gyfastas/EE397/MCU (Raspberry)/README.md

# Self-Balance-Robot

This project is an assignment in the Intelligent System course (EE397) aiming to implement a self balance robot based on ESP32-DevkitC-V3 and Raspberry Pi 3.

This sub repository contains the source codes of Raspberry in our project.

## Requirements

### Hardware chips

- __MCU(for visual)__ : Raspberry Pi 3
- __Camera__ : PiCamera
- __Edge Computing Support__ : Intel Movidius Neural Compute Stick

### Software

- __Python Version__ : Python 3.6
- __Dependent Libraries__ :
    + opencv-python
    + [ncsdk](https://github.com/movidius/ncsdk)
    + [ncappzoo](https://github.com/movidius/ncappzoo)
