gyfastas/EE397/Host/README.md

# EE397
Our EE397 project

Control UI on Computer

---------

## Environment

Python3.6

Pyqt5

## 上位机指令与通信协议

#### 11.11

前进 后退 左转 右转(WSAD) : 最低指令间隔10ms, 持续时间10ms

移动速度调整: 范围 (0,100) 怎么映射到底层参数上？
