gyfastas/EE397/MCU (Raspberry)/Demo/match.png

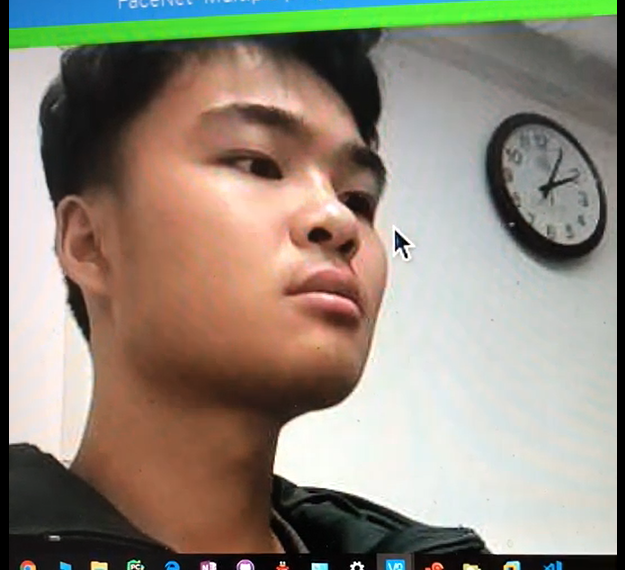
MCU (Raspberry)/Demo/match.png
