gyfastas/EE397/3DPrint/Drawing2.stl

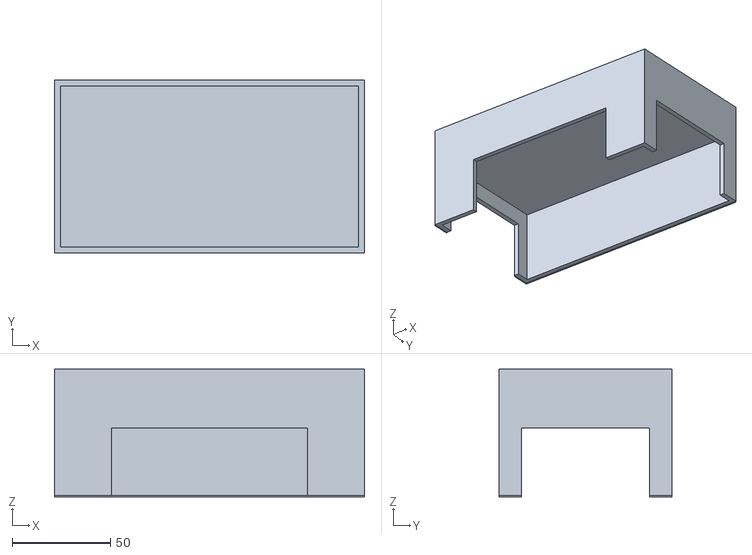
[picture p9: CAD file, 2018-12-17]
3DPrint/Drawing2.stl
158.0 x 88.0 x 65.0
