gyfastas/EE397/(list of files, drawings)

Other design files:
PCB Design/bala.PcbDoc
PCB Design/bala.SchDoc
