gyfastas/EE397/MCU (Raspberry)/live-object-detector_trackbottle.py

#!/usr/bin/python3

# ****************************************************************************
# Copyright(c) 2017 Intel Corporation. 
# License: MIT See LICENSE file in root directory.
# ****************************************************************************

# Detect objects on a LIVE camera feed using
# Intel® Movidius™ Neural Compute Stick (NCS)

import os
import cv2
import sys
import numpy
import ntpath
import argparse
import picamera
import picamera.array
import mvnc.mvncapi as mvnc

from utils import visualize_output
from utils import deserialize_output

import serial
import time
import multiprocess as mp
#import queue


# Detection threshold: Minimum confidance to tag as valid detection
CONFIDANCE_THRESHOLD = 0.60 # 60% confidant

# Variable to store commandline arguments
ARGS                 = None

# OpenCV object for video capture
camera               = None



ser = serial.Serial("/dev/ttyAMA0", 115200)
#open serial
def send(x):
    #字符发送
    ser.write(bytes([0x80]))
    ser.write(bytes([x]))
    ser.write(bytes([0x81]))
    ser.write(bytes([0x81]))

# ---- Step 1: Open the enumerated device and get a handle to it -------------

def open_ncs_device():

    # Look for enumerated NCS device(s); quit program if none found.
    devices = mvnc.EnumerateDevices()
    if len( devices ) == 0:
        print( "No devices found" )
        quit()

    # Get a handle to the first enumerated device and open it
    device = mvnc.Device( devices[0] )
    device.OpenDevice()

    return device

# ---- Step 2: Load a graph file onto the NCS device -------------------------

def load_graph( device ):

    # Read the graph file into a buffer
    with open( ARGS.graph, mode='rb' ) as f:
        blob = f.read()

    # Load the graph buffer into the NCS
    graph = device.AllocateGraph( blob )

    return graph

# ---- Step 3: Pre-process the images ----------------------------------------

def pre_process_image( frame ):

    # Resize image [Image size is defined by choosen network, during training]
    img = cv2.resize( frame, tuple( ARGS.dim ) )

    # Convert RGB to BGR [OpenCV reads image in BGR, some networks may need RGB]
    if( ARGS.colormode == "rgb" ):
        img = img[:, :, ::-1]

    # Mean subtraction & scaling [A common technique used to center the data]
    img = img.astype( numpy.float16 )
    img = ( img - numpy.float16( ARGS.mean ) ) * ARGS.scale

    return img

# ---- Step 4: Read & print inference results from the NCS -------------------

def infer_image( graph, img, frame ):

    # Load the image as a half-precision floating point array
    graph.LoadTensor( img, 'user object' )

    # Get the results from NCS
    output, userobj = graph.GetResult()

    # Get execution time
    inference_time = graph.GetGraphOption( mvnc.GraphOption.TIME_TAKEN )

    # Deserialize the output into a python dictionary
    output_dict = deserialize_output.ssd( 
                      output, 
                      CONFIDANCE_THRESHOLD, 
                      frame.shape )

    # Print the results (each image/frame may have multiple objects)
    print( "I found these objects in "
            + " ( %.2f ms ):" % ( numpy.sum( inference_time ) ) )
    flag = 0

    for i in range( 0, output_dict['num_detections'] ):
        print( "%3.1f%%\t" % output_dict['detection_scores_' + str(i)] 
               + labels[ int(output_dict['detection_classes_' + str(i)]) ]
               + ": Top Left: " + str( output_dict['detection_boxes_' + str(i)][0] )
               + " Bottom Right: " + str( output_dict['detection_boxes_' + str(i)][1] ) )

        # Draw bounding boxes around valid detections 
        (y1, x1) = output_dict.get('detection_boxes_' + str(i))[0]
        (y2, x2) = output_dict.get('detection_boxes_' + str(i))[1]
        if labels[output_dict.get('detection_classes_' + str(i))] == '5: bottle':
            flag = 1
            xdata1 = x1
            xdata2 = x2

        # Prep string to overlay on the image
        display_str = ( 
                labels[output_dict.get('detection_classes_' + str(i))]
                + ": "
                + str( output_dict.get('detection_scores_' + str(i) ) )
                + "%" )

        frame = visualize_output.draw_bounding_box( 
                       y1, x1, y2, x2, 
                       frame,
                       thickness=4,
                       color=(255, 255, 0),
                       display_str=display_str )
    print( '\n' )

    # If a display is available, show the image on which inference was performed
    if 'DISPLAY' in os.environ:
        cv2.imshow( 'NCS live inference', frame )
    if flag == 0:
        return int((xdata1+xdata2)/2)-288
    else:
        return -800

# ---- Step 5: Unload the graph and close the device -------------------------

def close_ncs_device( device, graph ):
    graph.DeallocateGraph()
    device.CloseDevice()
    camera.release()
    cv2.destroyAllWindows()

# ---- Main function (entry point for this script ) --------------------------

def main():

    device = open_ncs_device()
    graph = load_graph( device )
    thresh_angle = 25#bias permitted

    # Main loop: Capture live stream & send frames to NCS
    for frame in camera.capture_continuous(rawCapture, format="bgr", use_video_port=True):
       
        image = frame.array
        img = pre_process_image( image )
        dist = infer_image( graph, img, image )

        
    
        mes = 0x53
        if dist > thresh_angle:
           mes = 0x52#2 #R
        if dist < 0-thresh_angle and dist !=-800:
           mes = 0x4c#0x4c #L

        if dist <= thresh_angle and dist >= -thresh_angle:
           mes = 0x46#0x46#F
        if dist == -800:
           mes = 0x53

        send(0x53)
        send(mes)

        # Display the frame for 5ms, and close the window so that the next frame 
        # can be displayed. Close the window if 'q' or 'Q' is pressed.
        if( cv2.waitKey( 1 ) & 0xFF == ord( 'q' ) ):
            break

        # clear the stream in preparation for the next frame 
        rawCapture.truncate(0)

    close_ncs_device( device, graph )

# ---- Define 'main' function as the entry point for this script -------------

if __name__ == '__main__':

    parser = argparse.ArgumentParser(
                         description="Detect objects on a LIVE camera feed using \
                         Intel® Movidius™ Neural Compute Stick." )

    parser.add_argument( '-g', '--graph', type=str,
                         default='../../caffe/SSD_MobileNet/graph',
                         help="Absolute path to the neural network graph file." )

    parser.add_argument( '-v', '--video', type=int,
                         default=0,
                         help="Index of your computer's V4L2 video device. \
                               ex. 0 for /dev/video0" )

    parser.add_argument( '-l', '--labels', type=str,
                         default='../../caffe/SSD_MobileNet/labels.txt',
                         help="Absolute path to labels file." )

    parser.add_argument( '-M', '--mean', type=float,
                         nargs='+',
                         default=[127.5, 127.5, 127.5],
                         help="',' delimited floating point values for image mean." )

    parser.add_argument( '-S', '--scale', type=float,
                         default=0.00789,
                         help="Absolute path to labels file." )

    parser.add_argument( '-D', '--dim', type=int,
                         nargs='+',
                         default=[300, 300],
                         help="Image dimensions. ex. -D 224 224" )

    parser.add_argument( '-c', '--colormode', type=str,
                         default="bgr",
                         help="RGB vs BGR color sequence. This is network dependent." )

    ARGS = parser.parse_args()

    # Create a VideoCapture object
    camera = picamera.PiCamera()
    camera.resolution = (720,576)

    rawCapture = picamera.array.PiRGBArray(camera)
    # Load the labels file
    labels =[ line.rstrip('\n') for line in
              open( ARGS.labels ) if line != 'classes\n']

    main()

# ==== End of file ===========================================================
