gyfastas/EE397/MCU (Raspberry)/video_face_matcher_multiFace.py

#! /usr/bin/env python3

# Copyright(c) 2017 Intel Corporation. 
# License: MIT See LICENSE file in root directory.


from mvnc import mvncapi as mvnc
import numpy
import cv2
import sys
import os
import picamera
import picamera.array

EXAMPLES_BASE_DIR='../../'
IMAGES_DIR = './'

validated_image_list = os.listdir("./validated_images/")

GRAPH_FILENAME = "facenet_celeb_ncs.graph"

# name of the opencv window
CV_WINDOW_NAME = "FaceNet- Multiple people"

CAMERA_INDEX = 0
REQUEST_CAMERA_WIDTH = 640
REQUEST_CAMERA_HEIGHT = 480

# the same face will return 0.0
# different faces return higher numbers
# this is NOT between 0.0 and 1.0
FACE_MATCH_THRESHOLD = 0.8


# Run an inference on the passed image
# image_to_classify is the image on which an inference will be performed
#    upon successful return this image will be overlayed with boxes
#    and labels identifying the found objects within the image.
# ssd_mobilenet_graph is the Graph object from the NCAPI which will
#    be used to peform the inference.
def run_inference(image_to_classify, facenet_graph):

    # get a resized version of the image that is the dimensions
    # SSD Mobile net expects
    resized_image = preprocess_image(image_to_classify)

    # ***************************************************************
    # Send the image to the NCS
    # ***************************************************************
    facenet_graph.LoadTensor(resized_image.astype(numpy.float16), None)

    # ***************************************************************
    # Get the result from the NCS
    # ***************************************************************
    output, userobj = facenet_graph.GetResult()

    return output


# overlays the boxes and labels onto the display image.
# display_image is the image on which to overlay to
# image info is a text string to overlay onto the image.
# matching is a Boolean specifying if the image was a match.
# returns None
def overlay_on_image(display_image, image_info, matching):
    rect_width = 10
    offset = int(rect_width/2)
    if (image_info != None):
        cv2.putText(display_image, image_info, (30, 30), cv2.FONT_HERSHEY_SIMPLEX, 0.5, (255, 0, 0), 1)
    if (matching):
        # match, green rectangle
        cv2.rectangle(display_image, (0+offset, 0+offset),
                      (display_image.shape[1]-offset-1, display_image.shape[0]-offset-1),
                      (0, 255, 0), 10)
    else:
        # not a match, red rectangle
        cv2.rectangle(display_image, (0+offset, 0+offset),
                      (display_image.shape[1]-offset-1, display_image.shape[0]-offset-1),
                      (0, 0, 255), 10)


# whiten an image
def whiten_image(source_image):
    source_mean = numpy.mean(source_image)
    source_standard_deviation = numpy.std(source_image)
    std_adjusted = numpy.maximum(source_standard_deviation, 1.0 / numpy.sqrt(source_image.size))
    whitened_image = numpy.multiply(numpy.subtract(source_image, source_mean), 1 / std_adjusted)
    return whitened_image

# create a preprocessed image from the source image that matches the
# network expectations and return it
def preprocess_image(src):
    # scale the image
    NETWORK_WIDTH = 160
    NETWORK_HEIGHT = 160
    preprocessed_image = cv2.resize(src, (NETWORK_WIDTH, NETWORK_HEIGHT))

    #convert to RGB
    preprocessed_image = cv2.cvtColor(preprocessed_image, cv2.COLOR_BGR2RGB)

    #whiten
    preprocessed_image = whiten_image(preprocessed_image)

    # return the preprocessed image
    return preprocessed_image

# determine if two images are of matching faces based on the
# the network output for both images.
def face_match(face1_output, face2_output):
    if (len(face1_output) != len(face2_output)):
        print('length mismatch in face_match')
        return False
    total_diff = 0
    for output_index in range(0, len(face1_output)):
        this_diff = numpy.square(face1_output[output_index] - face2_output[output_index])
        total_diff += this_diff
    print('Total Difference is: ' + str(total_diff))
    return total_diff


# handles key presses
# raw_key is the return value from cv2.waitkey
# returns False if program should end, or True if should continue
def handle_keys(raw_key):
    ascii_code = raw_key & 0xFF
    if ((ascii_code == ord('q')) or (ascii_code == ord('Q'))):
        return False

    return True


# start the opencv webcam streaming and pass each frame
# from the camera to the facenet network for an inference
# Continue looping until the result of the camera frame inference
# matches the valid face output and then return.
# valid_output is inference result for the valid image
# validated image filename is the name of the valid image file
# graph is the ncsdk Graph object initialized with the facenet graph file
#   which we will run the inference on.
# returns None
def run_camera(valid_output, validated_image_filename, graph):
    camera = picamera.PiCamera()
    camera.resolution = (640,480)
    rawcapture = picamera.array.PiRGBArray(camera)
    cv2.namedWindow(CV_WINDOW_NAME)

    found_match = False
    for frame in camera.capture_continuous(rawcapture, format="bgr", use_video_port=True):
        # Read image from camera,
        vid_image = frame.array


        # run a single inference on the image and overwrite the
        # boxes and labels
        test_output = run_inference(vid_image, graph)

        min_distance = 100
        min_index = -1
        rawcapture.truncate(0)
        for i in range(0,len(valid_output)):
            distance = face_match(valid_output[i], test_output)
            if distance < min_distance:
                min_distance = distance
                min_index = i 

        if (min_distance<=FACE_MATCH_THRESHOLD):
            print('PASS!  File ' + ' matches ' + validated_image_list[min_index])
            found_match = True
        
        else:
            found_match = False
            print('FAIL!  File '+' does not match any image.')

        overlay_on_image(vid_image, 'frame', found_match)

        # check if the window is visible, this means the user hasn't closed
        # the window via the X button
        prop_val = cv2.getWindowProperty(CV_WINDOW_NAME, cv2.WND_PROP_ASPECT_RATIO)
        if (prop_val < 0.0):
            print('window closed')
            break

        # display the results and wait for user to hit a key
        cv2.imshow(CV_WINDOW_NAME, vid_image)
        raw_key = cv2.waitKey(1)
        if (raw_key != -1):
            if (handle_keys(raw_key) == False):
                print('user pressed Q')
                break

    if (found_match):
        cv2.imshow(CV_WINDOW_NAME, vid_image)
        cv2.waitKey(0)


# This function is called from the entry point to do
# all the work of the program
def main():
    use_camera = True

    # Get a list of ALL the sticks that are plugged in
    # we need at least one
    devices = mvnc.EnumerateDevices()
    if len(devices) == 0:
        print('No NCS devices found')
        quit()

    # Pick the first stick to run the network
    device = mvnc.Device(devices[0])

    # Open the NCS
    device.OpenDevice()

    # The graph file that was created with the ncsdk compiler
    graph_file_name = GRAPH_FILENAME

    # read in the graph file to memory buffer
    with open(graph_file_name, mode='rb') as f:
        graph_in_memory = f.read()

    # create the NCAPI graph instance from the memory buffer containing the graph file.
    graph = device.AllocateGraph(graph_in_memory)

    valid_output = []
    for i in validated_image_list:
        validated_image = cv2.imread("./validated_images/"+i)
        valid_output.append(run_inference(validated_image, graph))
    if (use_camera):
        run_camera(valid_output, validated_image_list, graph)
    else:
        input_image_filename_list = os.listdir(IMAGES_DIR)
        input_image_filename_list = [i for i in input_image_filename_list if i.endswith('.jpg')]
        if (len(input_image_filename_list) < 1):
            print('No .jpg files found')
            return 1
        run_images(valid_output, validated_image_list, graph, input_image_filename_list)

    # Clean up the graph and the device
    graph.DeallocateGraph()
    device.CloseDevice()


# main entry point for program. we'll call main() to do what needs to be done.
if __name__ == "__main__":
    main()
