gyfastas/EE397/MCU (ESP32)/test/testMPU6050.cpp

#include <Wire.h>
#include <MPU6050.h>

#define MPU6050_ADDR         0x68 // MPU-6050 device address
#define MPU6050_SMPLRT_DIV   0x19 // MPU-6050 register address
#define MPU6050_CONFIG       0x1a
#define MPU6050_GYRO_CONFIG  0x1b
#define MPU6050_ACCEL_CONFIG 0x1c
#define MPU6050_WHO_AM_I     0x75
#define MPU6050_PWR_MGMT_1   0x6b

double offsetX = 0, offsetY = 0, offsetZ = 0;
double gyro_angle_x = 0, gyro_angle_y = 0, gyro_angle_z = 0;
float angleX, angleY, angleZ;
float interval, preInterval;
float acc_x, acc_y, acc_z, acc_angle_x, acc_angle_y;
float gx, gy, gz, dpsX, dpsY, dpsZ;

void culcRotation();



void setup() {

  Wire.begin(21, 22);
  MPU6050.begin();
  delay(100);
  Serial.begin(115200);
}

void loop() {

  calcRotation();

  Serial.print("angleX : ");
  Serial.print(angleX);
  Serial.print("    angleY : ");
  Serial.print(angleY);
  Serial.print("    angleZ : ");
  Serial.println(angleZ);
 
}

//加速度、ジャイロから角度を計算
void calcRotation(){

  int16_t raw_acc_x, raw_acc_y, raw_acc_z, raw_t, raw_gyro_x, raw_gyro_y, raw_gyro_z ;

  raw_t = 0;
  MPU6050.getMotion6(&raw_acc_x, &raw_acc_y, &raw_acc_z, &raw_gyro_x, &raw_gyro_y, &raw_gyro_z);
  
  //単位Gへ変換
  acc_x = ((float)raw_acc_x) / 16384.0;
  acc_y = ((float)raw_acc_y) / 16384.0;
  acc_z = ((float)raw_acc_z) / 16384.0;
  
  //加速度センサーから角度を算出
  acc_angle_y = atan2(acc_x, acc_z + abs(acc_y)) * 360 / -2.0 / PI;
  acc_angle_x = atan2(acc_y, acc_z + abs(acc_x)) * 360 / 2.0 / PI;

  dpsX = ((float)raw_gyro_x) / 65.5; // LSB sensitivity: 65.5 LSB/dps @ ±500dps
  dpsY = ((float)raw_gyro_y) / 65.5;
  dpsZ = ((float)raw_gyro_z) / 65.5;
  
  //前回計算した時から今までの経過時間を算出
  interval = millis() - preInterval;
  preInterval = millis();
  
  //数値積分
  gyro_angle_x += (dpsX - offsetX) * (interval * 0.001);
  gyro_angle_y += (dpsY - offsetY) * (interval * 0.001);
  gyro_angle_z += (dpsZ - offsetZ) * (interval * 0.001);
  
  //相補フィルター
  angleX = (0.996 * gyro_angle_x) + (0.004 * acc_angle_x);
  angleY = (0.996 * gyro_angle_y) + (0.004 * acc_angle_y);
  angleZ = gyro_angle_z;
  gyro_angle_x = angleX;
  gyro_angle_y = angleY;
  gyro_angle_z = angleZ;
}
