gyfastas/EE397/(commit log)

2018-10-15 Add WiFi communication
    1. Basic framework is done.
    2. TODO: PID parameters tuning.
2018-10-16 Optimization
    1. Change the motor controller from PD to PID;
    2. Optimize methods for EEPROM access.
2018-10-17 Update
    1. Now it can maintain self-balance;
    2. TODO: implement turn-loop PID controller, optimize WiFi remote control protocol (Now without interrupts, the core control program will be blocked when communicating with host computer).
2018-10-31 update PPT
    [智能系统设计模块安排.xlsx]
2018-11-02 RTOS
    1. Schedule tasks with RTOS.
    2. Package methods of EEPROM access.
    3. TODO: add turn-loop PID controller.
2018-11-03 Update
    1. Add several new parameters to be tuned.
    2. Modify WiFi connection, and the protocol for communication between host and ESP32.
    3. Add turn-loop PID controller. (Now commented)
2018-11-03 update 报告
2018-11-03 Revert "update 报告"
    This reverts commit 9ba15a43d546e3d8f7d0f356cf77bcb7e95f8be0.
2018-11-04 update cmd
    更新了可视化命令行（纯文本编辑）
2018-11-04 update slider and edit
    完成了 Slider 和 Edit 的交互逻辑
2018-11-04 update TCP
    使用我们的命令行与远端服务器可以通信了
2018-11-04 delete
    删除了一些没用的东西
2018-11-12 Update
    1. Add Ultrasonic library.
    2. Refactor the project, dividing into three parts: TopDesign, WiFiControl and BalaControl.
2018-11-18 Detection
    1. Finish hardware and mechanical structure.
    2. Add Ultrasonic distance detection and battery voltage detection.
2018-11-19 update
    1. Replace wificontrol to web control
    [TopDesign.ino, WebControl.ino]
2018-11-19 Finish merge
    [智能系统设计模块安排.xlsx]
2018-11-25 11.26
    更新了当前工作纪录，上传了图像处理代码和uart通信测试代码
2018-11-26 updata11_26
    更新了代码，完成了字符串的输入输出，合并了图像显示与通信，协议在通信.md里
2018-11-29 上传循迹文件
    目前参数th,th1未调，目前做到了对直线偏差的调整，刷新时间也未调。
2018-11-30 tracking更新
    blackline有问题，运行太慢
2018-12-02 Refactor
    1. Refactor web server page.
    2. Modify ADC calibration (wait for test with multimeter)
2018-12-02 Fix bugs
    1. PID balance loop: gyro_y -> gyro_x;
    2. Task schedule;
    3. Issues: two wheels are at different speeds
    [Bala.cpp, WebControl.ino, testADC.cpp]
2018-12-02 Fix Bala.cpp
    add a new _constrain function to deal with double
    [Bala.cpp, Bala.h, TopDesign.ino]
2018-12-02 Replace WebServer.h with AsyncWebServer.h
    [TopDesign.ino, WebControl.ino]
2018-12-02 Update bug
    something wrong with switch
    [WebControl.ino]
2018-12-02 Add avoidance mode (without test)
    [DistDetection.ino, TopDesign.ino, WebControl.ino]
2018-12-02 Add codes about communication with Raspberry
    1. Communication succeed.
2018-12-02 黑线直线检测OK
    但是阈值参数未调，窗口也无法关闭
2018-12-02 Update tracking.py
    等待调试th参数
2018-12-02 Fixed ESP32 3.3V VDD_SDIO
    [WebControl.ino]
2018-12-10 Update 3Dprint
    1.The 3D Printer model .stl done
    [Drawing2.stl]
2018-12-10 Create tracking_1.py
    tracking 更改摄像头
2018-12-10 Add precise rotation control
    1. Fix bug in ultrasonic distance detection: when timeout, return MAXDIST instead of 0;
    2. Add rotate certain yaw angle event (without test)
    [Bala.cpp, Bala.h, CertainMotionControl.ino, DistDetection.ino, TopDesign.ino, Ultrasonic.cpp, WebControl.ino]
2018-12-10 Add a left-side ultrasonic
2018-12-10 Update tracking_1.py
    已经基本完成寻线功能，需要解决线程崩溃问题
2018-12-11 Maze solver
    1. Finish maze solver second pass coding
    2. Precise motion control!!!!! need to be improved!!!
    3. Now it can solve the maze on the first pass and can also simplify the path, but there is still something wrong with path show on web server and the second pass.
    [DistDetection.ino, MazeSolver.ino, RaspberryControl.ino, TopDesign.ino, WebControl.ino]
2018-12-13 Update tracking_1.py
    寻线算法12.13，flag初值问题，右转弯无法保证
2018-12-14 Create test_vision2.py
    已经可以运行，但是不能直角右转
2018-12-14 Create the fininal vision.py
    代码完成
2018-12-14 Modify maze solver
    1. Still something wrong with the second pass
    2. Precise motion control!!
    [MazeSolver.ino, TopDesign.ino, WebControl.ino]
2018-12-14 Revert README and LOG, refactor codes to be more well-commented
    [lineFollower(Charles).py, lineFollower(Rainfall).py]
2018-12-17 Add parameter to adjust the motor output of two wheels
2018-12-18 Create live-object-detector_trackbottle.py
    跟随算法
2018-12-18 update multiface recognintion
    [Drawing2.stl]
2018-12-18 Update README, Add PCB
    [bala.PcbDoc, bala.SchDoc]
