gyfastas/EE397/(notices)

Notices in the files:
MCU (ESP32)/TopDesign/TopDesign.ino:
This program is free software; you can redistribute it and/or modify
it under the terms of the GNU General Public License as published by
the Free Software Foundation; either version 2 of the License, or
(at your option) any later version.
